cosmicteam2022/EVA/Final Version/models/3D printers/3d printer1.jpeg

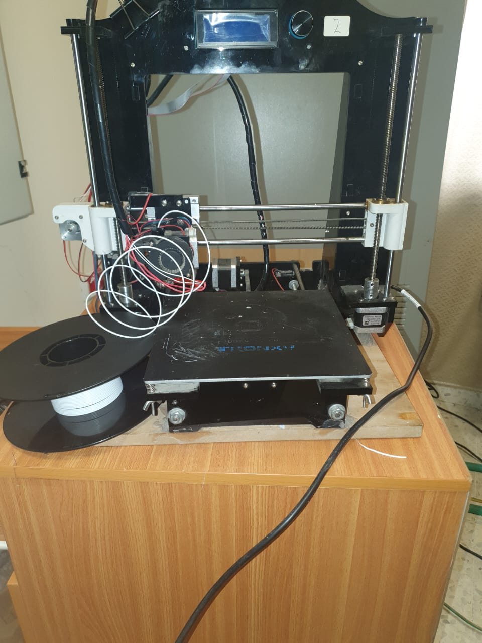
Final Version/models/3D printers/3d printer1.jpeg
