cosmicteam2022/EVA/Final Version/models/3D printers/room.jpeg

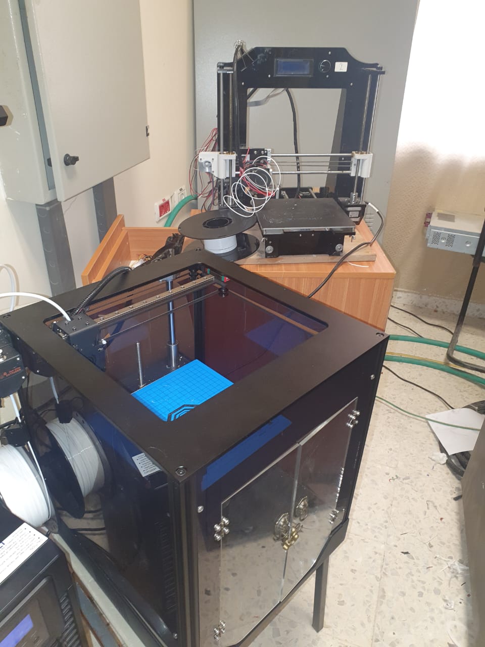
Final Version/models/3D printers/room.jpeg
