cosmicteam2022/EVA/Final Version/models/README.md

**This links for assembling EVA Robot**
<https://youtu.be/30cbxMJ-Umg>

**For  4WD RC Smart Car**
<https://www.youtube.com/watch?v=5MyHJwO-LVU>
