cosmicteam2022/EVA/Final Version/schemes/Final Main Diagram.jpeg

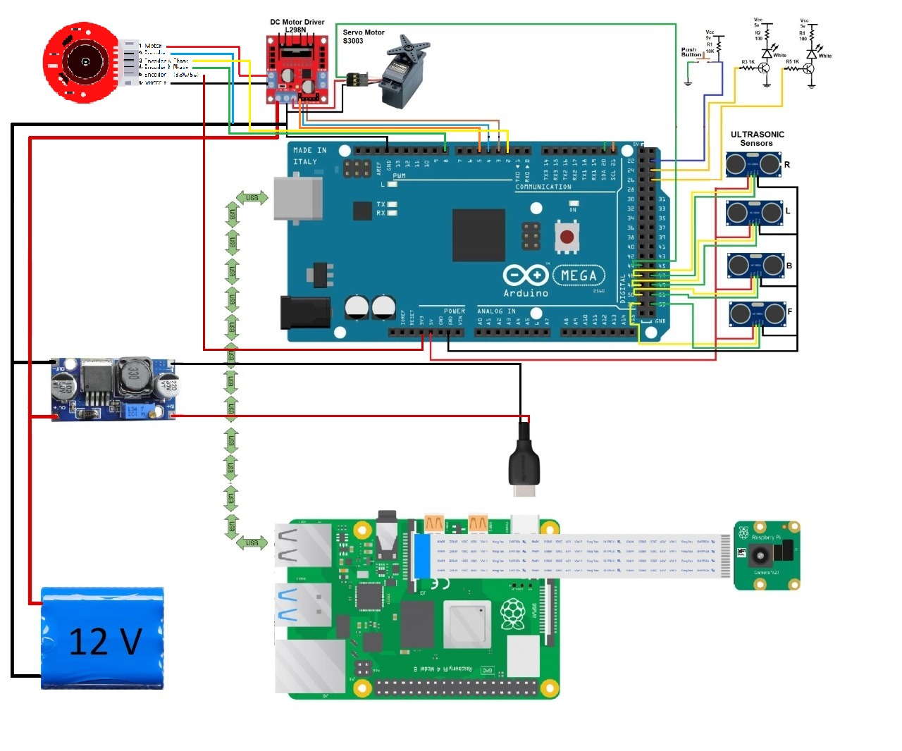
Final Version/schemes/Final Main Diagram.jpeg
