cosmicteam2022/EVA/Final Version/t-photos/Funny.jpeg

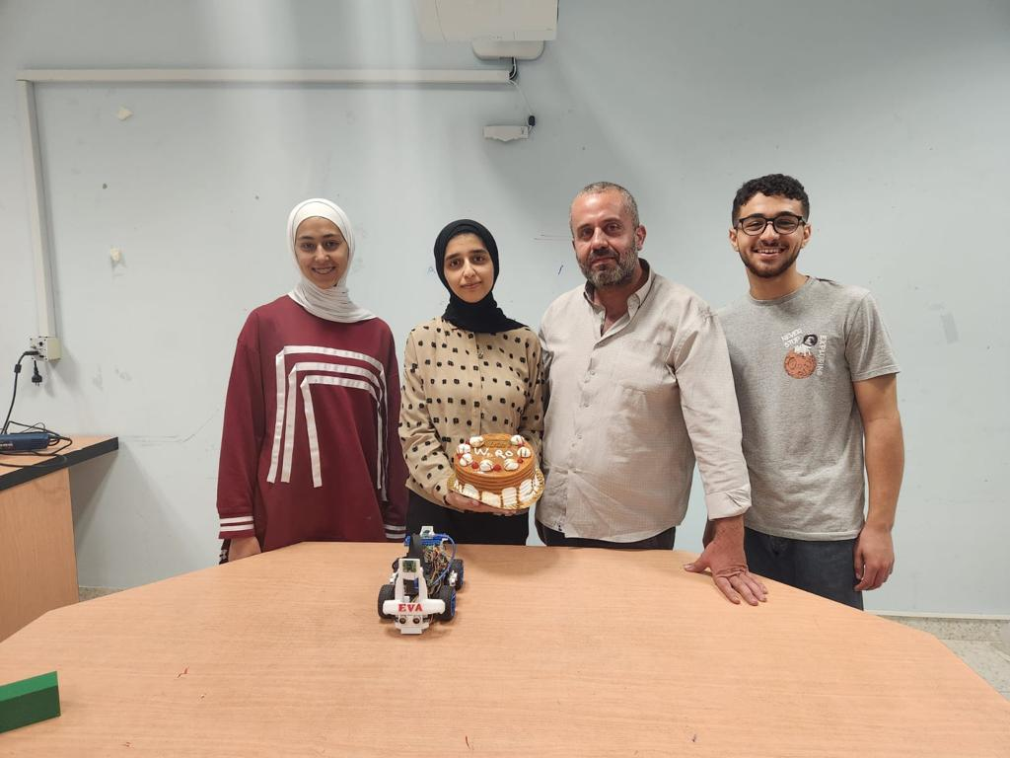
Final Version/t-photos/Funny.jpeg
