cosmicteam2022/EVA/Final Version/t-photos/official.jpg

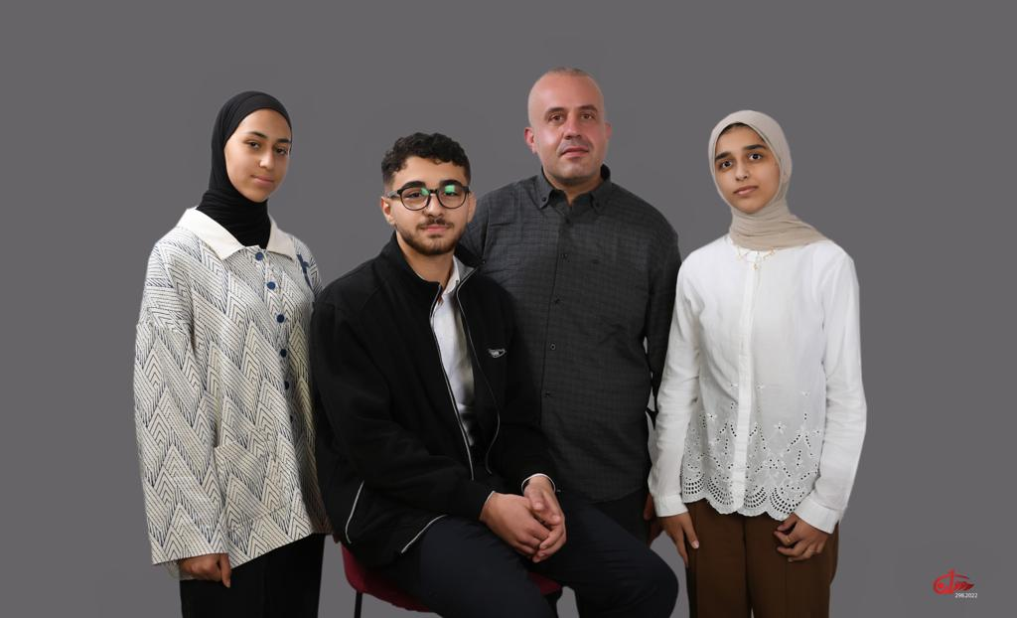
Final Version/t-photos/official.jpg
