cosmicteam2022/EVA/Final Version/v-photos/Back Side.jpeg

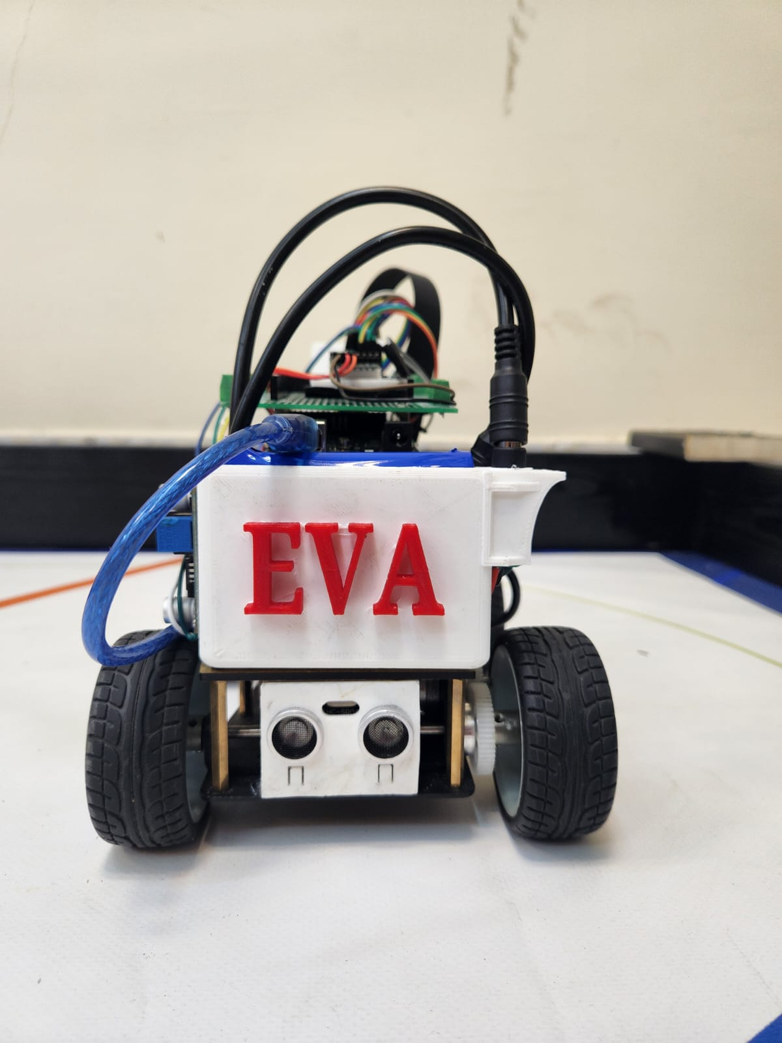
Final Version/v-photos/Back Side.jpeg
