cosmicteam2022/EVA/Final Version/v-photos/Down Side.jpeg

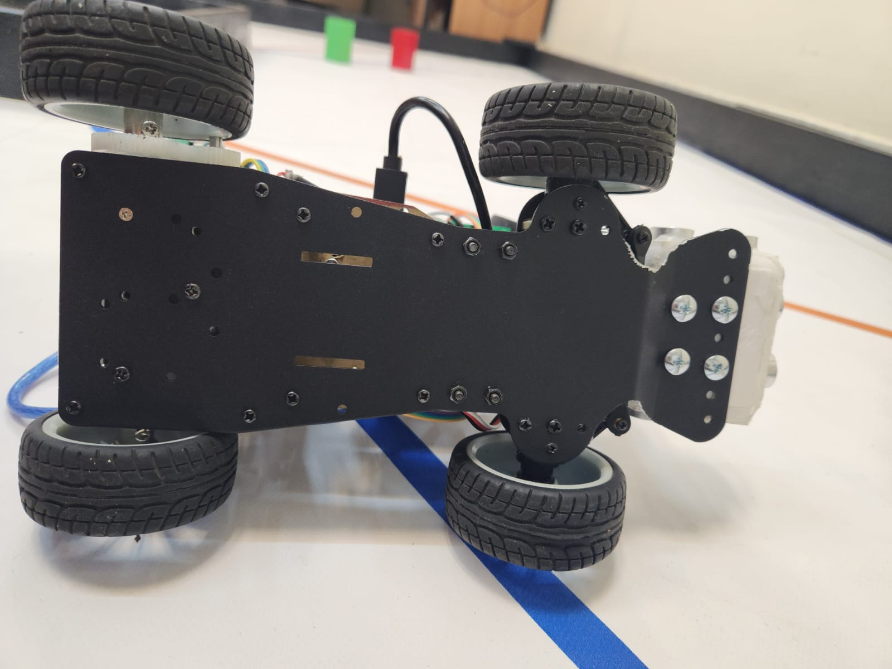
Final Version/v-photos/Down Side.jpeg
