cosmicteam2022/EVA/Final Version/v-photos/Front Side.jpeg

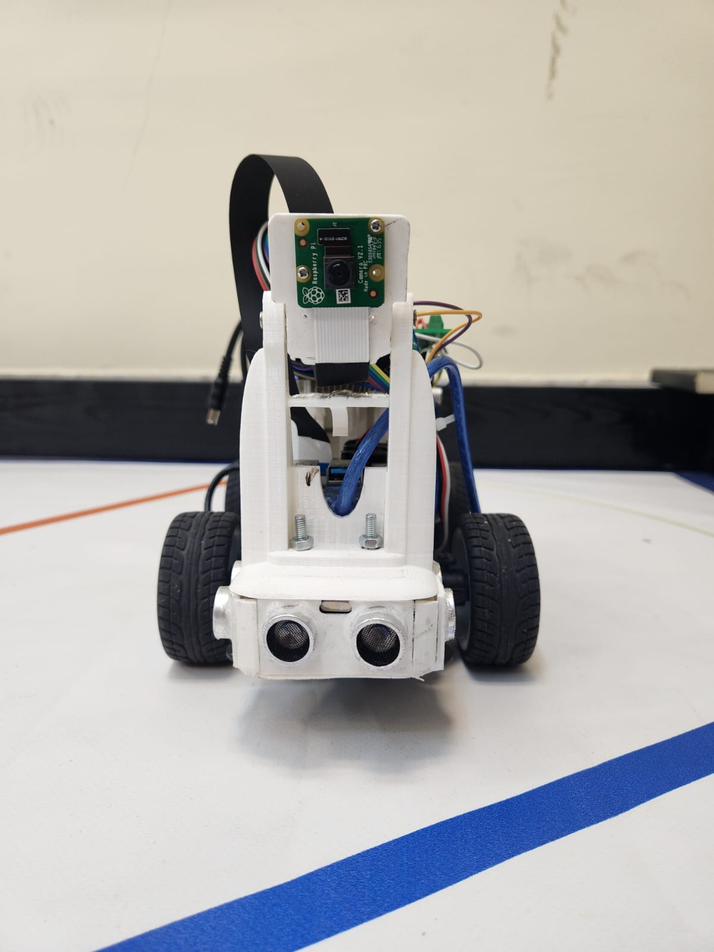
Final Version/v-photos/Front Side.jpeg
