cosmicteam2022/EVA/Final Version/v-photos/Left Side.jpeg

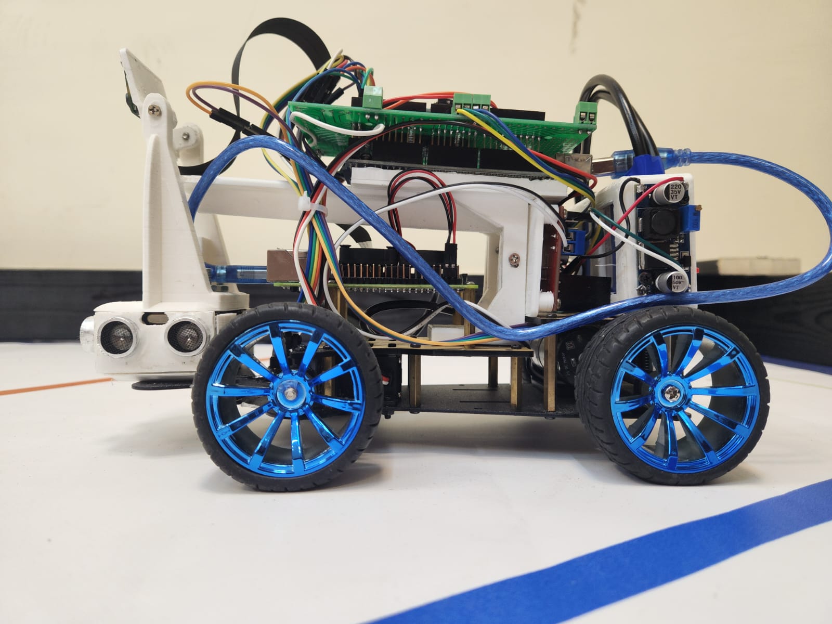
Final Version/v-photos/Left Side.jpeg
