cosmicteam2022/EVA/Final Version/v-photos/Right Side.jpeg

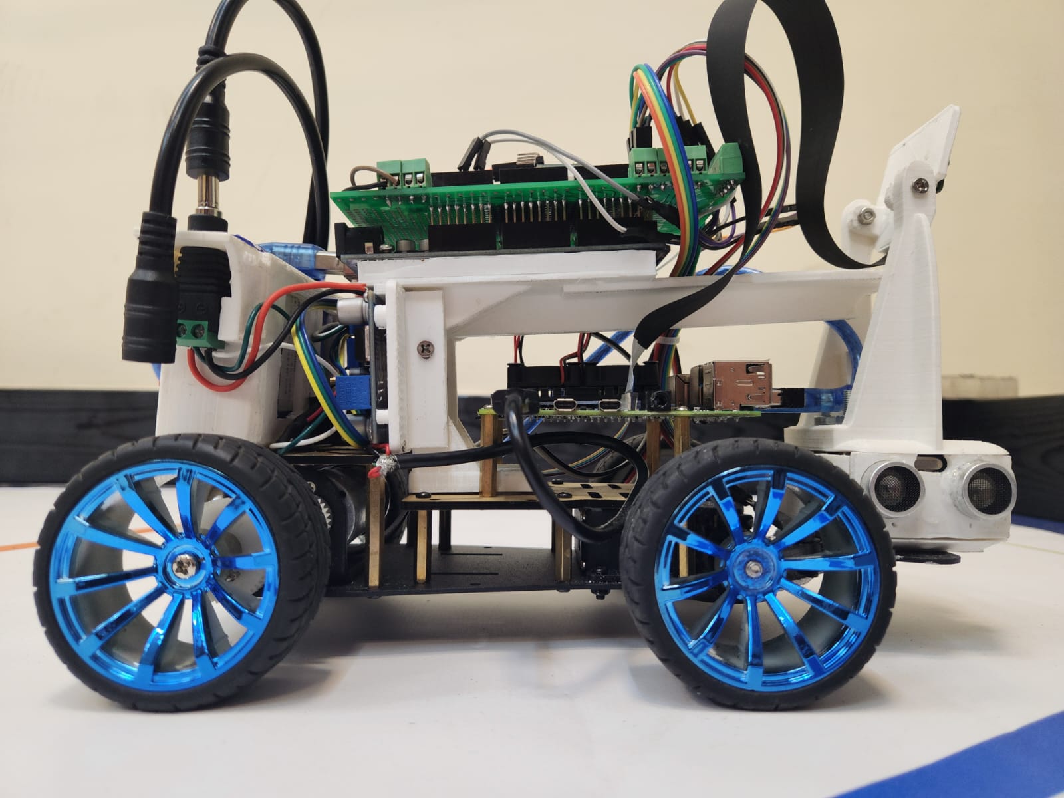
Final Version/v-photos/Right Side.jpeg
