cosmicteam2022/EVA/Final Version/v-photos/Top Side.jpeg

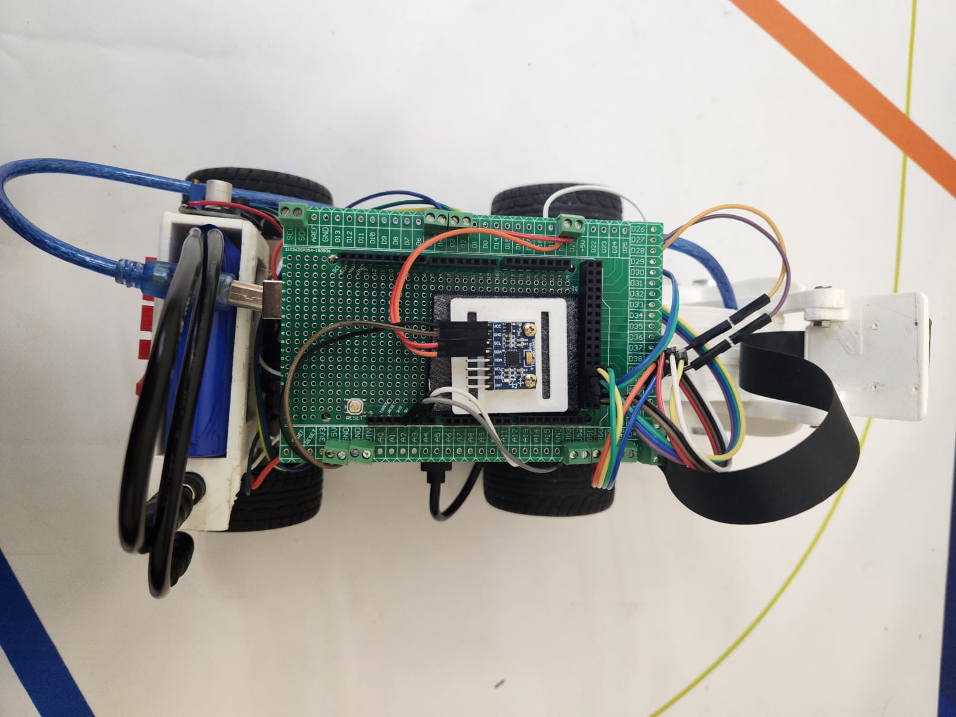
Final Version/v-photos/Top Side.jpeg
