cosmicteam2022/EVA/Final Version/models/Back Ultrasonic/tinker.obj

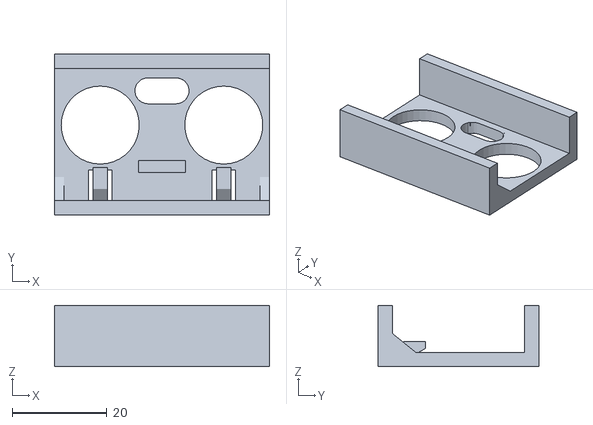
[picture p59: CAD file, 2022-10-21]
Final Version/models/Back Ultrasonic/tinker.obj
45.5 x 34.0 x 13.0
