cosmicteam2022/EVA/Final Version/models/Battery Holder/tinker.obj

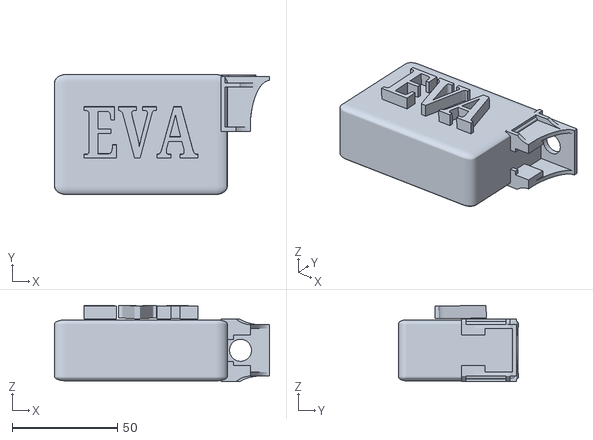
[picture p60: CAD file, 2022-10-21]
Final Version/models/Battery Holder/tinker.obj
102.0 x 57.0 x 36.2
