cosmicteam2022/EVA/Final Version/models/Camera Holder/tinker.obj

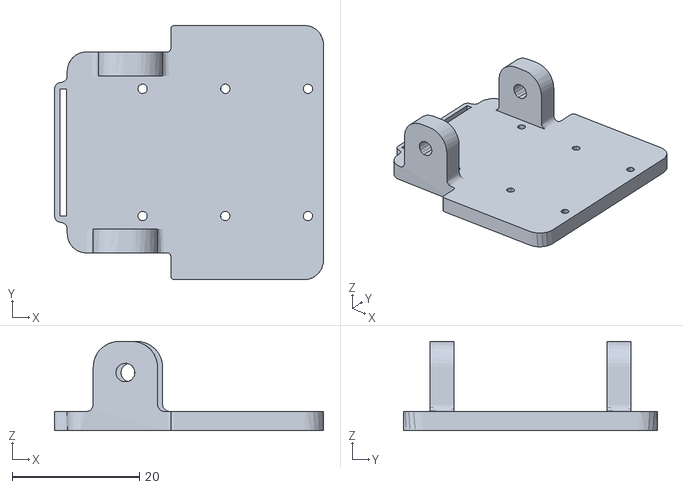
[picture p61: CAD file, 2022-10-21]
Final Version/models/Camera Holder/tinker.obj
42.3 x 40.0 x 14.0
