cosmicteam2022/EVA/Final Version/models/Driver and Power/tinker.obj

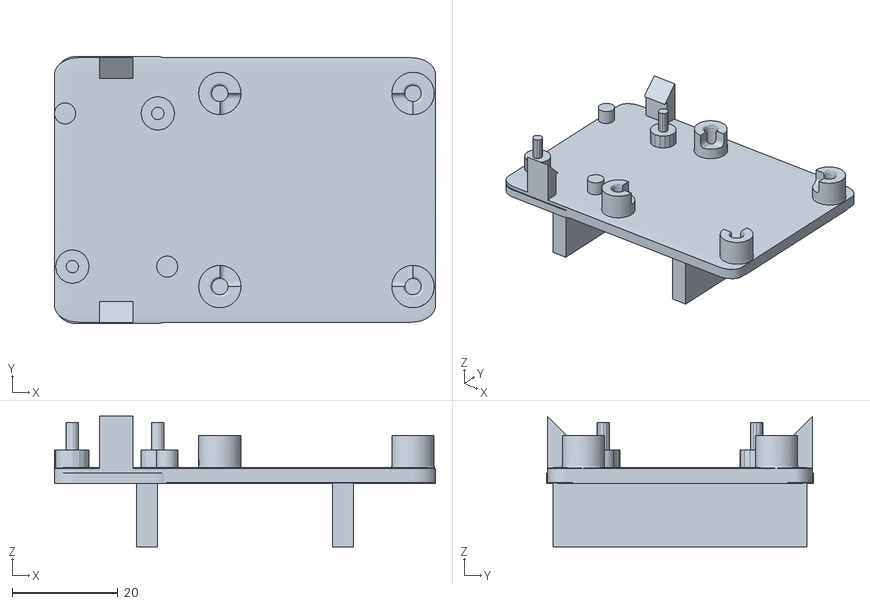
[picture p62: CAD file, 2022-10-21]
Final Version/models/Driver and Power/tinker.obj
72.0 x 50.5 x 24.7
