cosmicteam2022/EVA/Final Version/models/EVA/tinker.obj

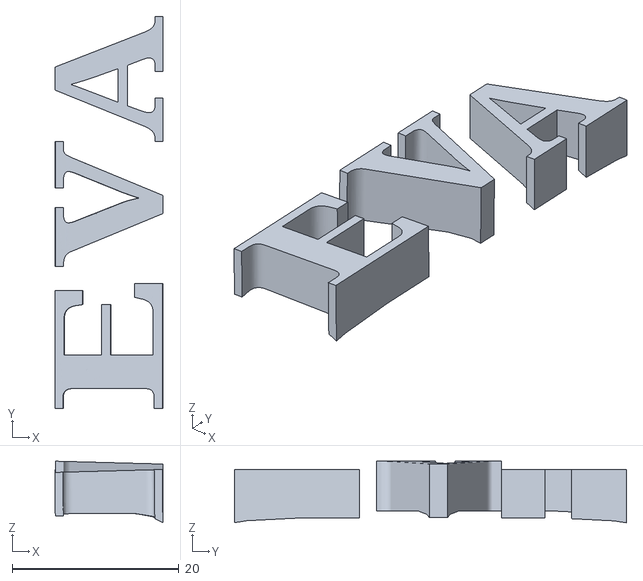
[picture p63: CAD file, 2022-10-21]
Final Version/models/EVA/tinker.obj
13.0 x 47.0 x 7.39
