cosmicteam2022/EVA/Final Version/models/Final 3D designs/cam stand.stl

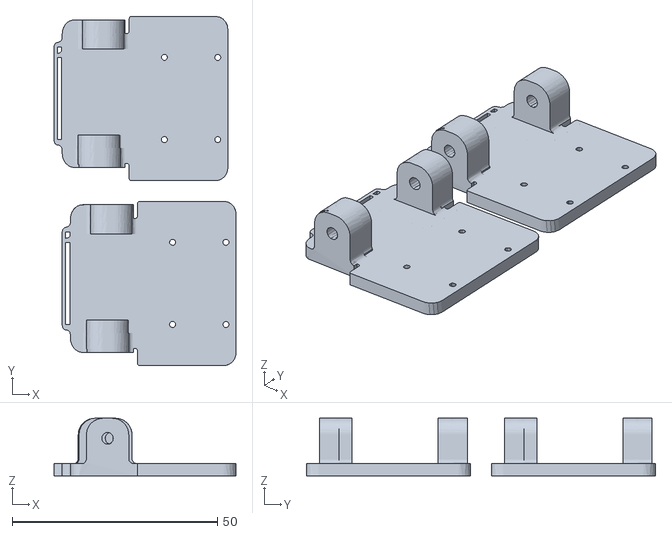
[picture p64: CAD file, 2022-11-14]
Final Version/models/Final 3D designs/cam stand.stl
44.3 x 85.0 x 14.0
