cosmicteam2022/EVA/Final Version/models/Led holder/tinker.obj

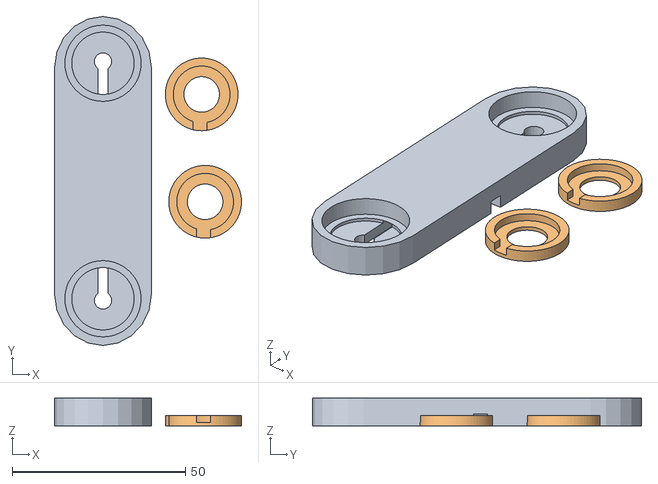
[picture p65: CAD file, 2022-10-21]
Final Version/models/Led holder/tinker.obj
54.0 x 95.0 x 8.00
