cosmicteam2022/EVA/Final Version/models/Magnificent Blorr/tinker.obj

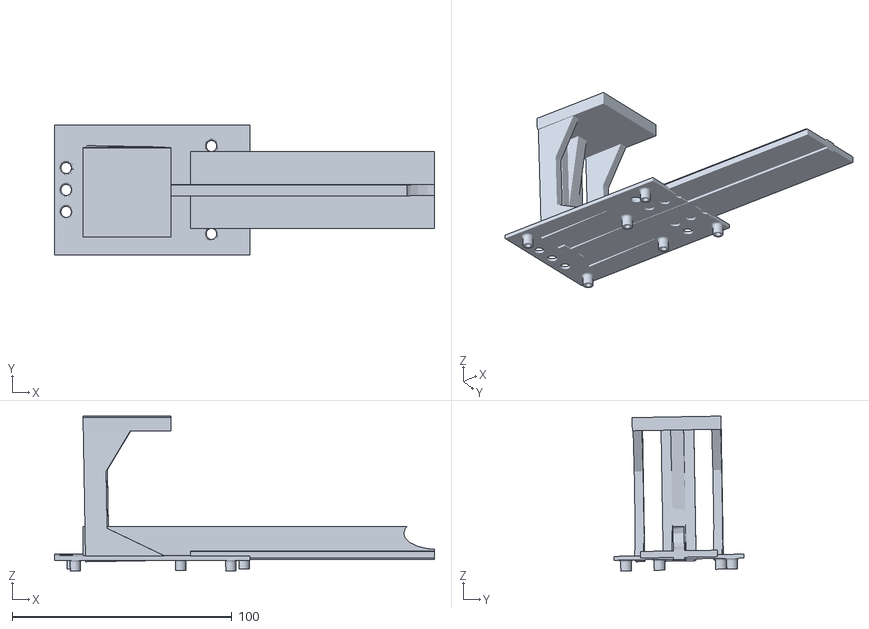
[picture p66: CAD file, 2022-10-21]
Final Version/models/Magnificent Blorr/tinker.obj
173.0 x 59.0 x 70.5
