cosmicteam2022/EVA/Final Version/models/mpuplusultra/tinker.obj

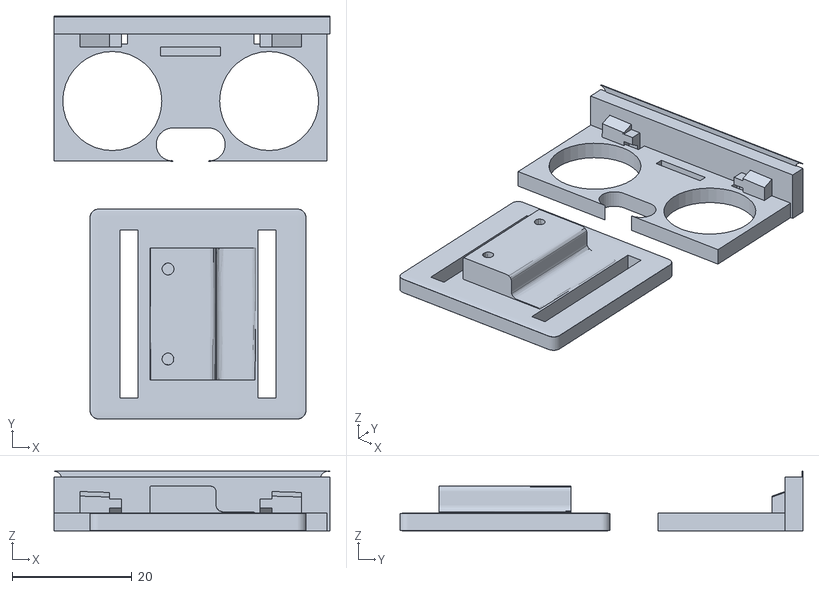
[picture p67: CAD file, 2022-10-21]
Final Version/models/mpuplusultra/tinker.obj
46.0 x 67.2 x 10.00
