cosmicteam2022/EVA/Final Version/models/Smashing Hango/tinker.obj

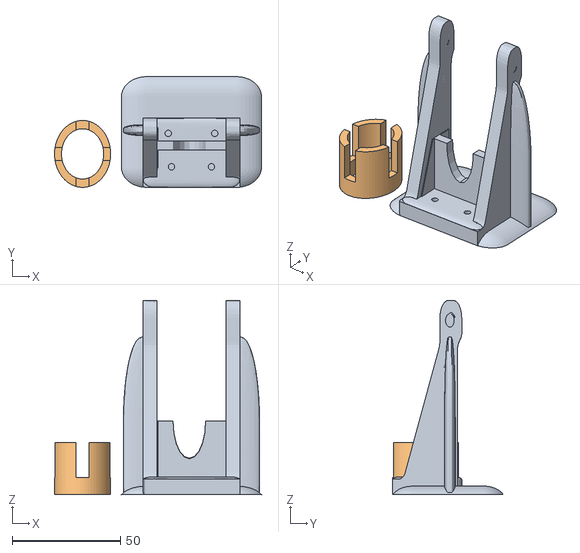
[picture p68: CAD file, 2022-10-21]
Final Version/models/Smashing Hango/tinker.obj
95.8 x 51.3 x 90.0
