cosmicteam2022/EVA/Final Version/models/Tremendous Esboo-Blorr/tinker.obj

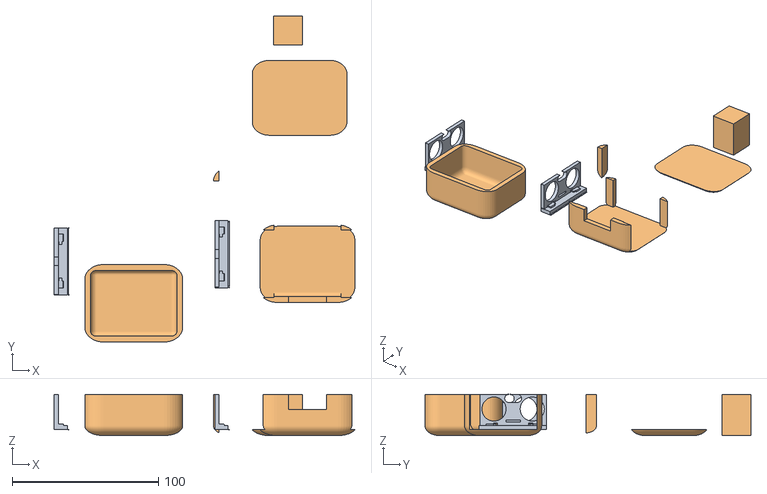
[picture p69: CAD file, 2022-10-21]
Final Version/models/Tremendous Esboo-Blorr/tinker.obj
205.8 x 223.1 x 28.2
