cosmicteam2022/EVA/Final Version/models/ultraFinal/tinker.obj

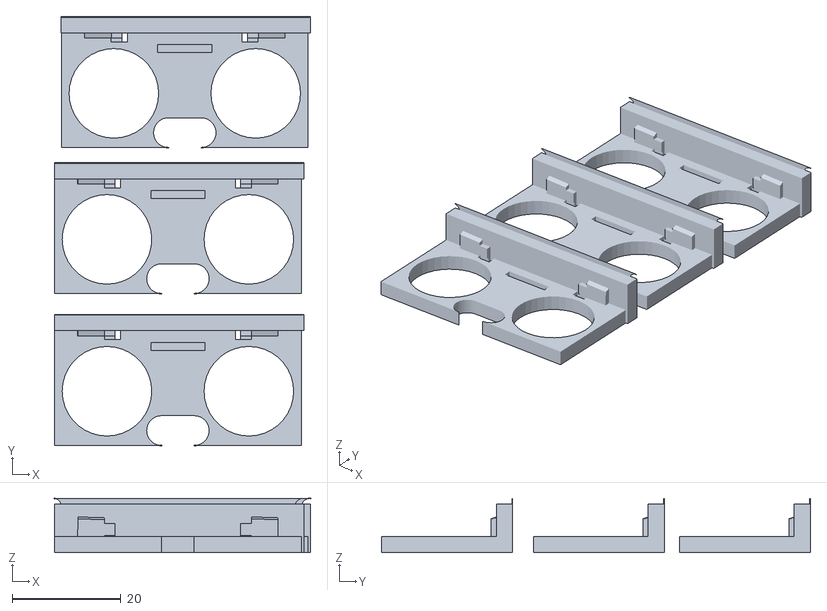
[picture p70: CAD file, 2022-10-21]
Final Version/models/ultraFinal/tinker.obj
47.3 x 79.1 x 10.00
