cosmicteam2022/EVA/Final Version/models/Final 3D designs/Ultrasonic and camera holder.stl

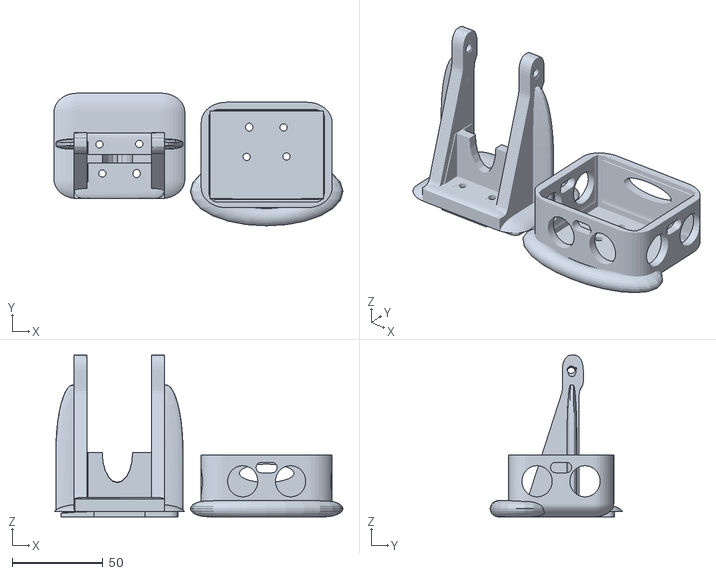
[picture p71: CAD file, 2022-11-14]
Final Version/models/Final 3D designs/Ultrasonic and camera holder.stl
159.0 x 73.0 x 89.0
