cosmicteam2022/EVA/Final Version/models/Final 3D designs/Final Mega stand.stl

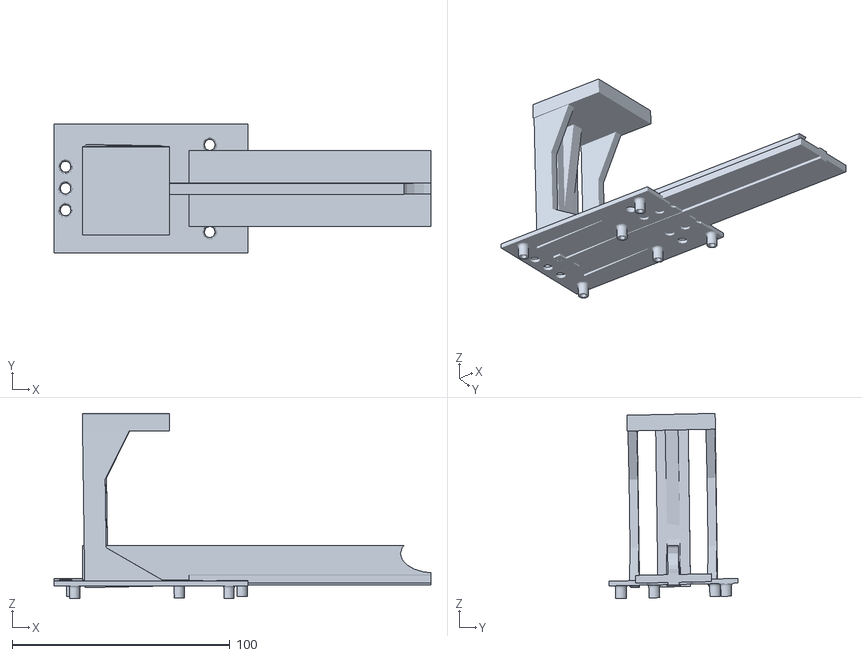
[picture p72: CAD file, 2022-11-14]
Final Version/models/Final 3D designs/Final Mega stand.stl
173.0 x 59.0 x 85.0
