cosmicteam2022/EVA/Final Version/models/Final 3D designs/FinalBattaryHolder.stl

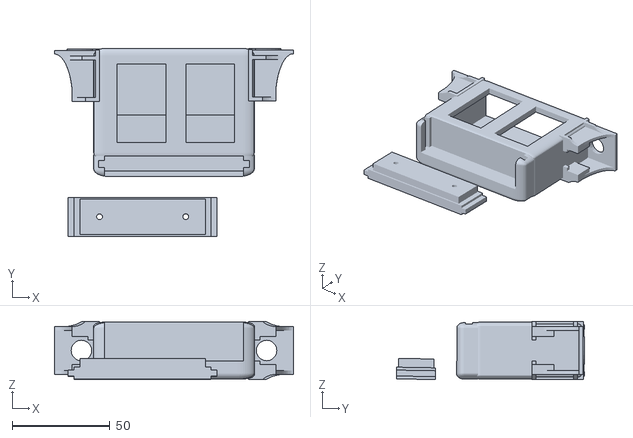
[picture p73: CAD file, 2022-11-14]
Final Version/models/Final 3D designs/FinalBattaryHolder.stl
122.0 x 96.1 x 29.7
