cosmicteam2022/EVA/Final Version/models/Final 3D designs/Driver and power.stl

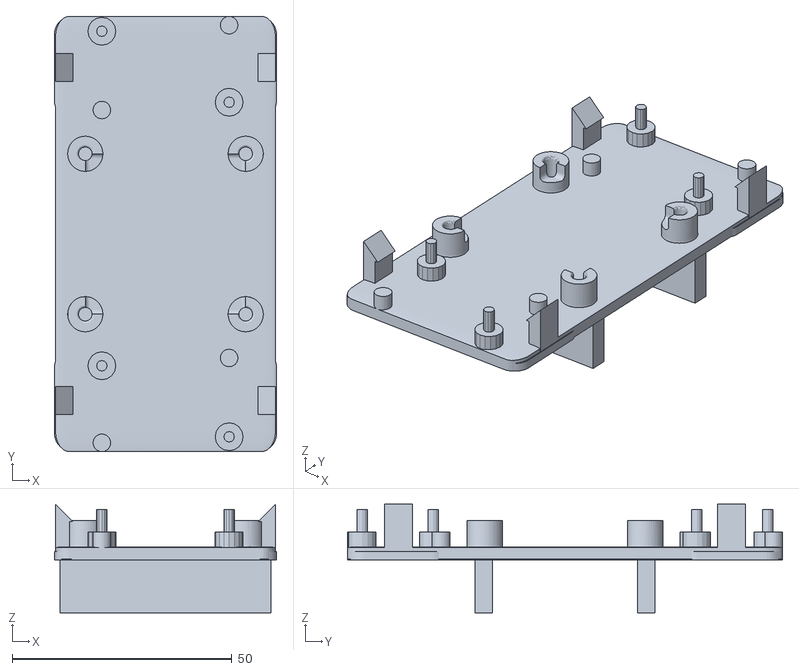
[picture p74: CAD file, 2022-11-14]
Final Version/models/Final 3D designs/Driver and power.stl
50.5 x 99.0 x 24.7
