cosmicteam2022/EVA/Final Version/schemes/schemes_tutorial_link.md

**This link how to built robot EVA**

<https://www.youtube.com/watch?v=30cbxMJ-Umg>
