cosmicteam2022/EVA/Final Version/models/3D printers/3d printer2.jpeg

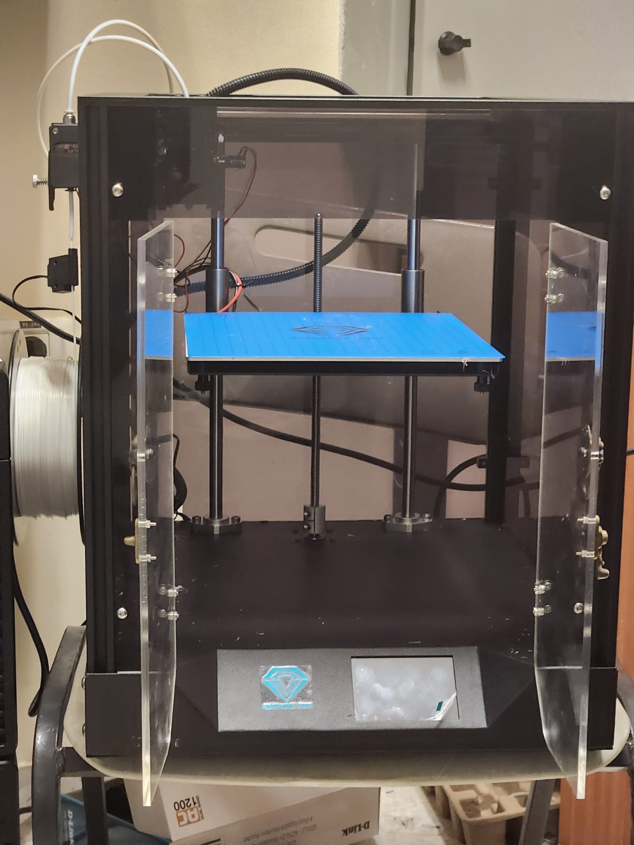
Final Version/models/3D printers/3d printer2.jpeg
