cosmicteam2022/EVA/(commit log)

2022-10-18 Rename Arduino Camera.ino to Final Version/Code/Arduino Camera.ino
2022-10-18 Rename Arduino Camera.ino to Arduino Camera V0.ino
2022-10-18 Rename Camera.py to Final Version/Code/Python Camera Code.py
2022-10-21 Rename Final Version/models/t.txt to Final Version/models/3D printers/t.txt
